kuba2k2/CDCEmu/hardware/v4.0/CDCEmu_v4.0-bottom.png

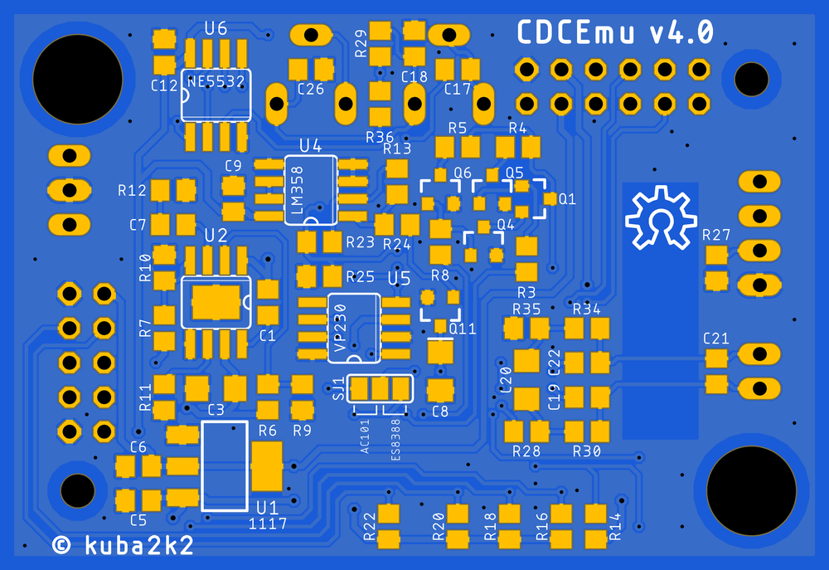
hardware/v4.0/CDCEmu_v4.0-bottom.png
