kuba2k2/CDCEmu/hardware/CDCEmu.brd

## EAGLE design hardware/CDCEmu.brd (2023-04-24)

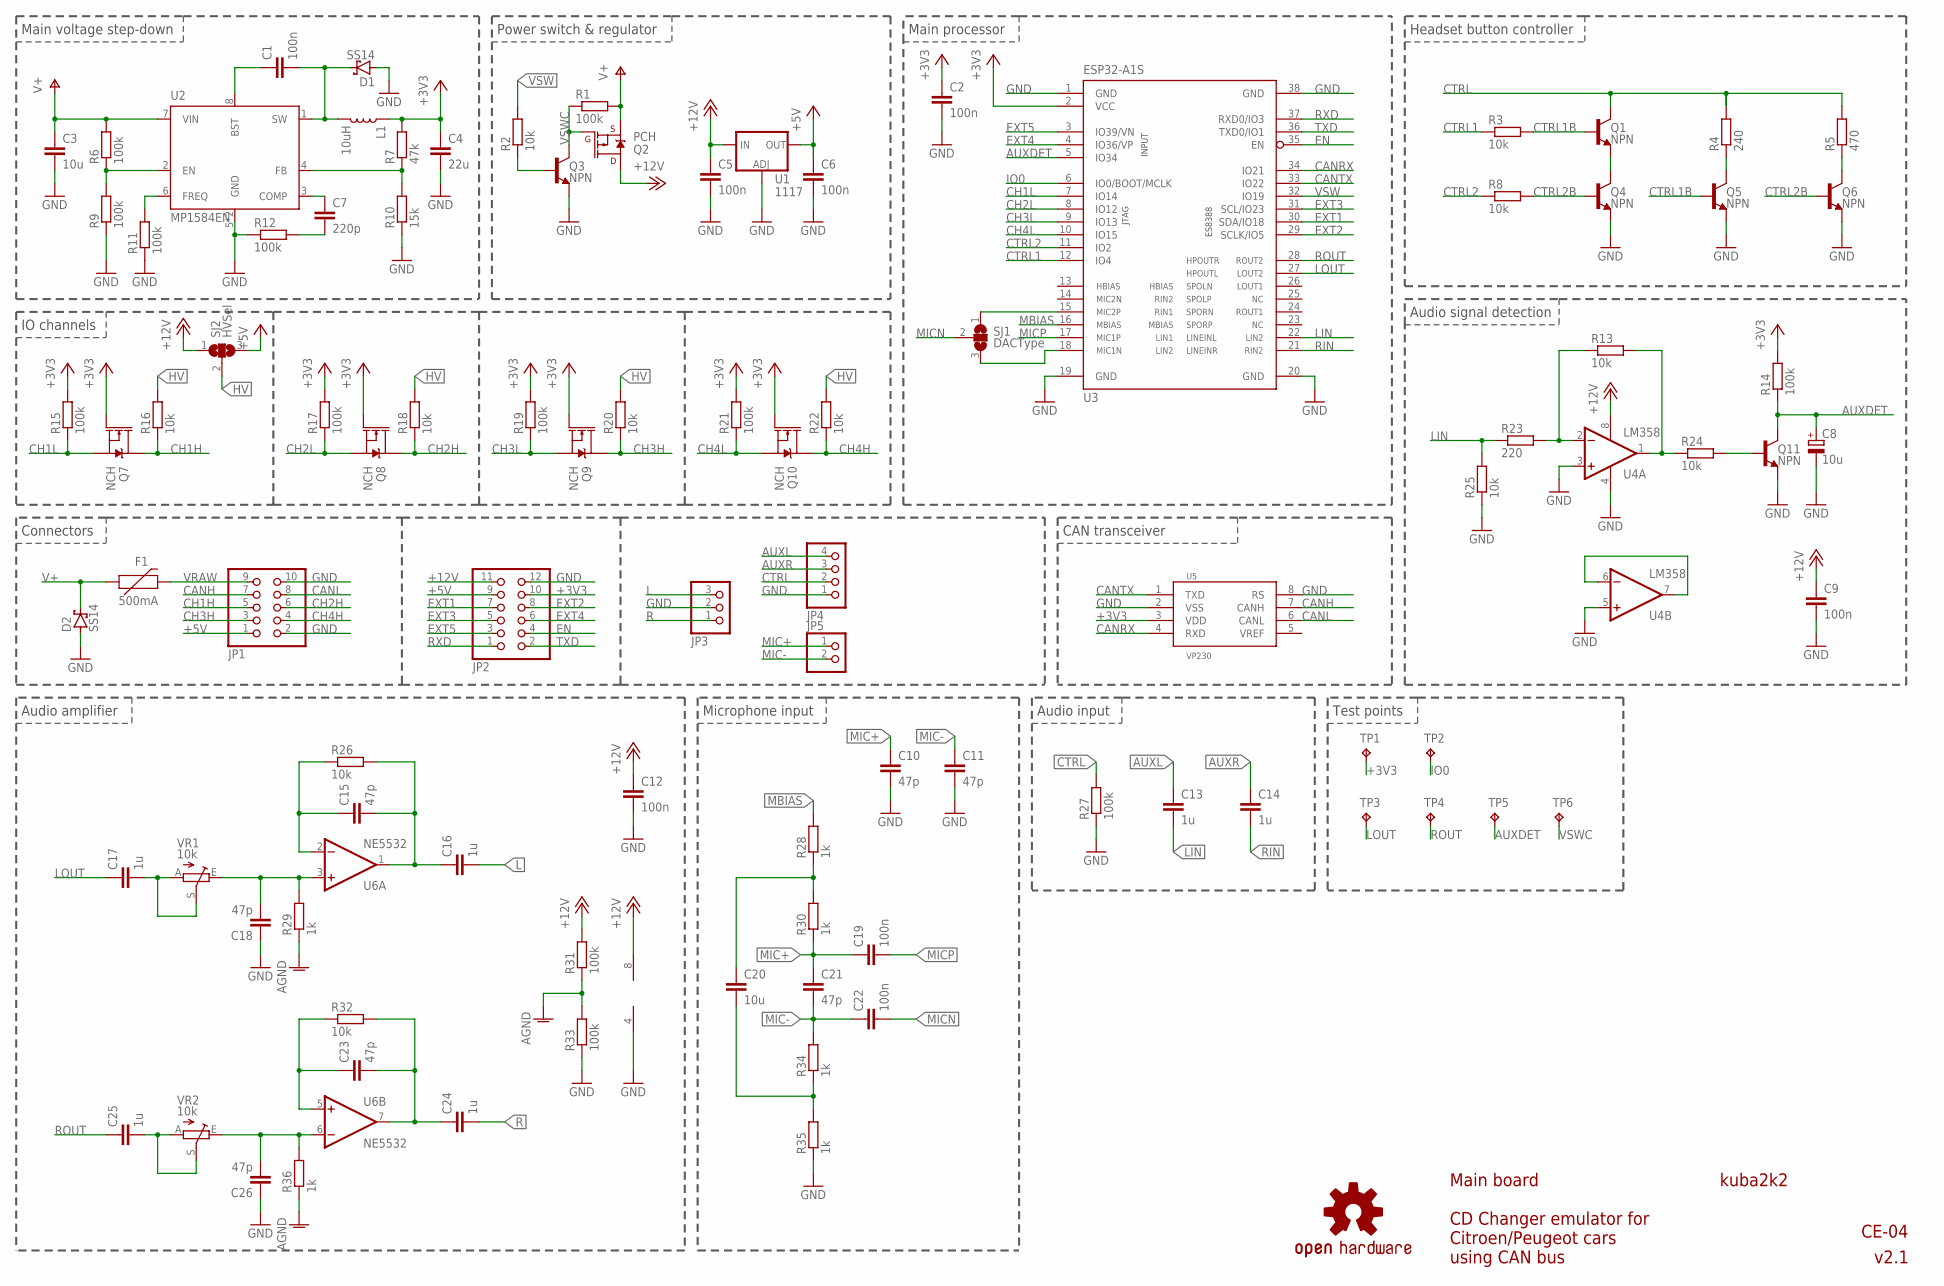
[picture p4: schematic CDCEmu.sch]

Parts:
C1, C2, C5, C6, C9, C12, C19, C22: 100n; C0805
C3, C20: 10u; C1206
C4: 22u; C1206
C7: 220p; C0805
C8: 10u; C1206-POL
C10, C11, C15, C18, C21, C23, C26: 47p; C0805
C13, C14, C16, C17, C24, C25: 1u; C0805
D1, D2: SS14; DO-214AC
F1: 500mA; 0805
JP1: PINHD-2X5/90; 2X05/90
JP2: PINHD-2X6/90; 2X06/90
JP3: PINHD-1X3/90; 1X03/90
JP4: PINHD-1X4/90; 1X04/90
JP5: PINHD-1X2/90; 1X02/90
L1: 10uH; CR75
Q1, Q3, Q4, Q5, Q6, Q11: NPN; SOT23-3
Q2: PCH; SOT23-3
Q7, Q8, Q9, Q10: NCH; SOT23-3
R1, R6, R9, R11, R12, R14, R15, R17, R19, R21, R27, R31, R33: 100k; R0805
R2, R3, R8, R13, R16, R18, R20, R22, R24, R25, R26, R32: 10k; R0805
R4: 240; R0805
R5: 470; R0805
R7: 47k; R0805
R10: 15k; R0805
R23: 220; R0805
R28, R29, R30, R34, R35, R36: 1k; R0805
SJ1: DACType; SJ_2
SJ2: HVSel; SJ_2
TP1, TP2, TP3, TP4, TP5, TP6: TPB1,27; B1,27
U1: 1117; SOT223
U2: MP1584EN; SO08-PAD
U3: ESP32-A1S
U4: LM358; SO08
U5: VP230; SO08
U6: NE5532; SO08
U$1: OSHW-LOGO; OSHWLOGO_TOP_0.2_OUTLINE
VR1, VR2: 10k; CA6V

Connections:
+3V3: C2.1, C4.1, JP2.10, L1.P$1 (1), Q7.1 (G), Q8.1 (G), Q9.1 (G), Q10.1 (G), R7.2, R14.2, R15.2, R17.2, R19.2, R21.2, TP1.TP, U3.2 (VCC), U5.3 (VDD)
+5V: C6.1, JP1.1, JP2.9, SJ2.3, U1.2 (OUT), U1.4 (OUT)
+12V: C5.1, C9.1, C12.1, JP2.11, Q2.3 (D), R31.2, SJ2.1, U1.3 (IN), U4.8 (V+), U6.8 (V+)
AGND: R29.1, R31.1, R33.2, R36.1
AUXDET: C8.1 (+), Q11.3 (C), R14.1, TP5.TP, U3.5 (IO34)
AUXL: C13.1, JP4.4
AUXR: C14.1, JP4.3
BST: C1.1, U2.8 (BST)
CANH: JP1.7, U5.7 (CANH)
CANL: JP1.8, U5.6 (CANL)
CANRX: U3.34 (IO21), U5.4 (RXD)
CANTX: U3.33 (IO22), U5.1 (TXD)
CCE: Q1.2 (E), Q4.3 (C)
CH1H: JP1.5, Q7.3 (D), R16.1
CH1L: Q7.2 (S), R15.1, U3.7 (IO14)
CH2H: JP1.6, Q8.3 (D), R18.1
CH2L: Q8.2 (S), R17.1, U3.8 (IO12)
CH3H: JP1.3, Q9.3 (D), R20.1
CH3L: Q9.2 (S), R19.1, U3.9 (IO13)
CH4H: JP1.4, Q10.3 (D), R22.1
CH4L: Q10.2 (S), R21.1, U3.10 (IO15)
COMP: C7.1, U2.3 (COMP)
COMPD: C7.2, R12.2
CTRL: JP4.2, Q1.3 (C), R4.2, R5.2, R27.2
CTRL1: R3.1, U3.12 (IO4)
CTRL1B: Q1.1 (B), Q5.1 (B), R3.2
CTRL2: R8.1, U3.11 (IO2)
CTRL2B: Q4.1 (B), Q6.1 (B), R8.2
DET-: R13.1, R23.2, U4.2 (-IN)
DETOUT: R13.2, R24.1, U4.1 (OUT)
DET_B: Q11.1 (B), R24.2
EN: JP2.4, U3.35 (EN)
EXT1: JP2.7, U3.30 (SDA/IO18)
EXT2: JP2.8, U3.29 (SCLK/IO5)
EXT3: JP2.5, U3.31 (SCL/IO23)
EXT4: JP2.6, U3.4 (IO36/VP)
EXT5: JP2.3, U3.3 (IO39/VN)
FB: R7.1, R10.2, U2.4 (FB)
FREQ: R11.2, U2.6 (FREQ)
GND: C2.2, C3.2, C4.2, C5.2, C6.2, C8.2 (-), C9.2, C10.2, C11.2, C12.2, C18.1, C26.1, D1.A, D2.A, JP1.2, JP1.10, JP2.12, JP3.2, JP4.1, Q3.2 (E), Q4.2 (E), Q5.2 (E), Q6.2 (E), Q11.2 (E), R9.1, R10.1, R11.1, R12.1, R25.1, R27.1, R33.1, R35.1, U1.1 (ADJ), U2.5 (GND), U2.PAD (GND), U3.1 (GND), U3.19 (GND), U3.20 (GND), U3.38 (GND), U4.3 (+IN), U4.4 (V-), U4.5 (+IN), U5.2 (VSS), U5.8 (RS), U6.4 (V-)
HV: R16.2, R18.2, R20.2, R22.2, SJ2.2
IO0: TP2.TP, U3.6 (IO0/BOOT/MCLK)
L: C16.2, JP3.3
LF: C17.2, VR1.A, VR1.S
LFB: C15.2, C16.1, R26.2, U6.1 (OUT)
LIN: C13.2, R23.1, R25.2, U3.22 (LINEINL/LIN2)
LNEG: C15.1, R26.1, U6.2 (-IN)
LOUT: C17.1, TP3.TP, U3.27 (HPOUTL/LOUT2)
LPOS: C18.2, R29.2, U6.3 (+IN), VR1.E
MBIAS: R28.2, U3.16 (MBIAS)
MG+: C20.1, R28.1, R30.2
MG-: C20.2, R34.1, R35.2
MIC1N: SJ1.3, U3.18 (MIC1N/LIN2)
MIC+: C10.1, C19.1, C21.1, JP5.1, R30.1
MIC-: C11.1, C21.2, C22.1, JP5.2, R34.2
MICN: C22.2, SJ1.2
MICP: C19.2, U3.17 (MIC1P/LIN1)
MPEN: R6.1, R9.2, U2.2 (EN)
Q8C: Q5.3 (C), R4.1
Q9C: Q6.3 (C), R5.1
R: C24.2, JP3.1
RF: C25.2, VR2.A, VR2.S
RFB: C23.2, C24.1, R32.2, U6.7 (OUT)
RIN: C14.2, U3.21 (LINEINR/RIN2)
RIN1: SJ1.1, U3.15 (MIC2P/RIN1)
RNEG: C23.1, R32.1, U6.5 (+IN)
ROUT: C25.1, TP4.TP, U3.28 (HPOUTR/ROUT2)
RPOS: C26.2, R36.2, U6.6 (-IN), VR2.E
RXD: JP2.1, U3.37 (RXD0/IO3)
SW: C1.2, D1.C, L1.P$2 (2), U2.1 (SW)
TXD: JP2.2, U3.36 (TXD0/IO1)
U4FB: U4.6 (-IN), U4.7 (OUT)
V+: C3.1, D2.C, F1.1, Q2.2 (S), R1.2, R6.2, U2.7 (VIN)
VRAW: F1.2, JP1.9
VSW: R2.2, U3.32 (IO19)
VSWB: Q3.1 (B), R2.1
VSWC: Q2.1 (G), Q3.3 (C), R1.1, TP6.TP

Notes on the sheet:
Audio amplifier
Power switch & regulator
Headset button controller
Microphone input
kuba2k2
v2.1
CE-04
CD Changer emulator for Citroen/Peugeot cars using CAN bus
Main board
Audio signal detection
IO channels
Main voltage step-down
Main processor
Connectors
CAN transceiver
Audio input
Test points

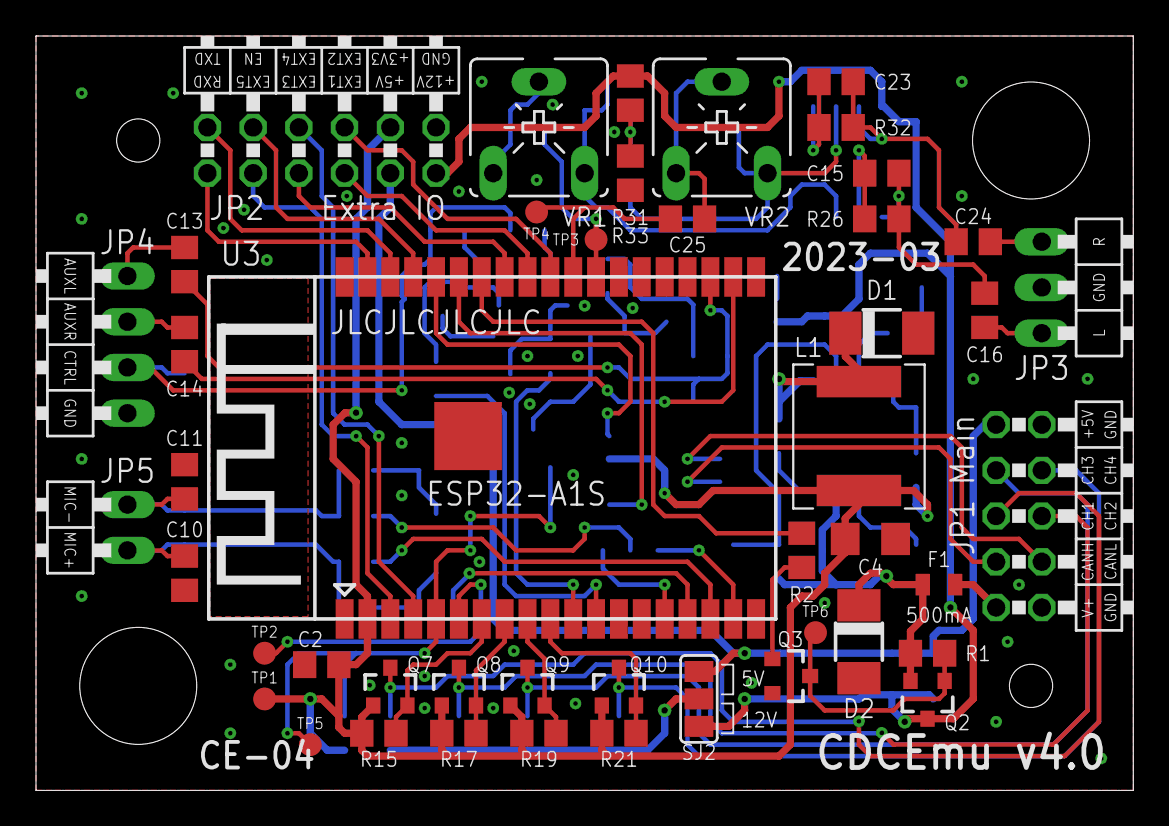
[picture p5: board CDCEmu.brd from above]

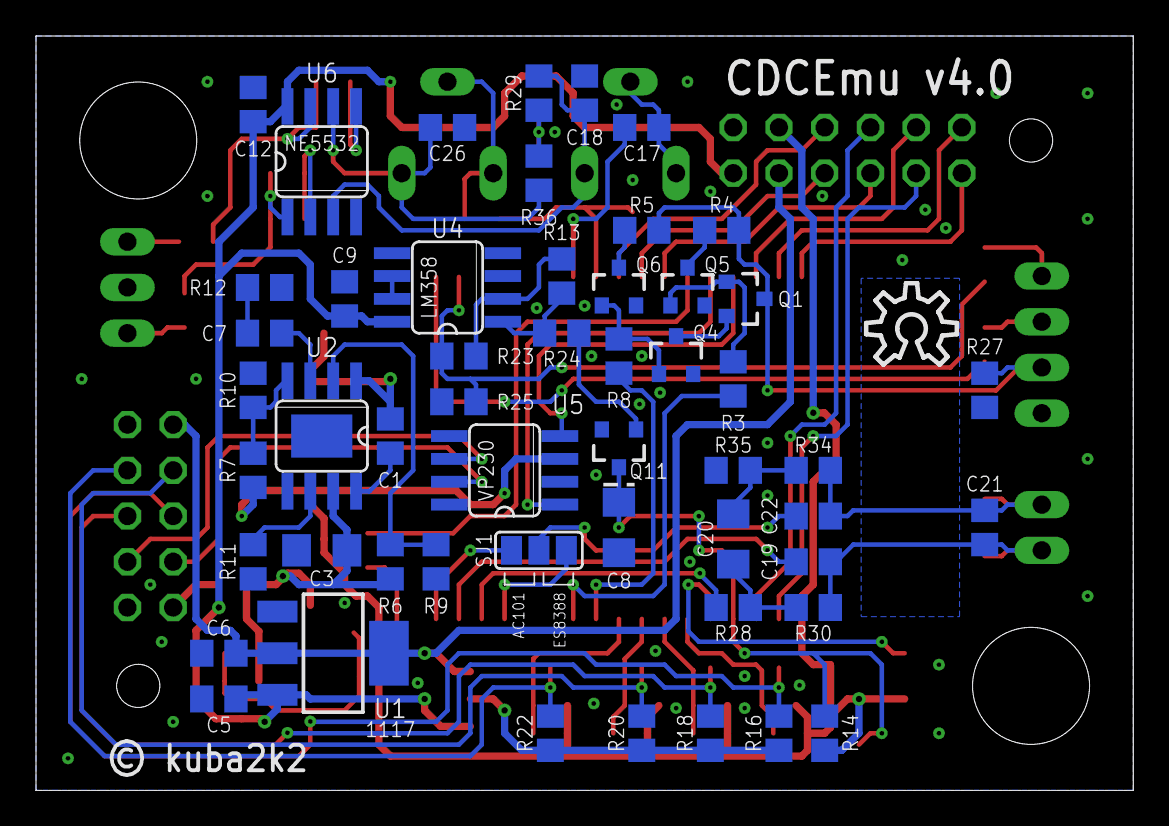
[picture p6: board CDCEmu.brd from below]

Board: 2 copper layers, 61.0 x 41.9 mm, 99 parts (53 on the bottom side), 77 nets.
