kuba2k2/CDCEmu/hardware/v2.1/CDCEmu_Analog_v2.1.brd

## EAGLE design hardware/v2.1/CDCEmu_Analog_v2.1.brd (2022-03-11, an earlier design)

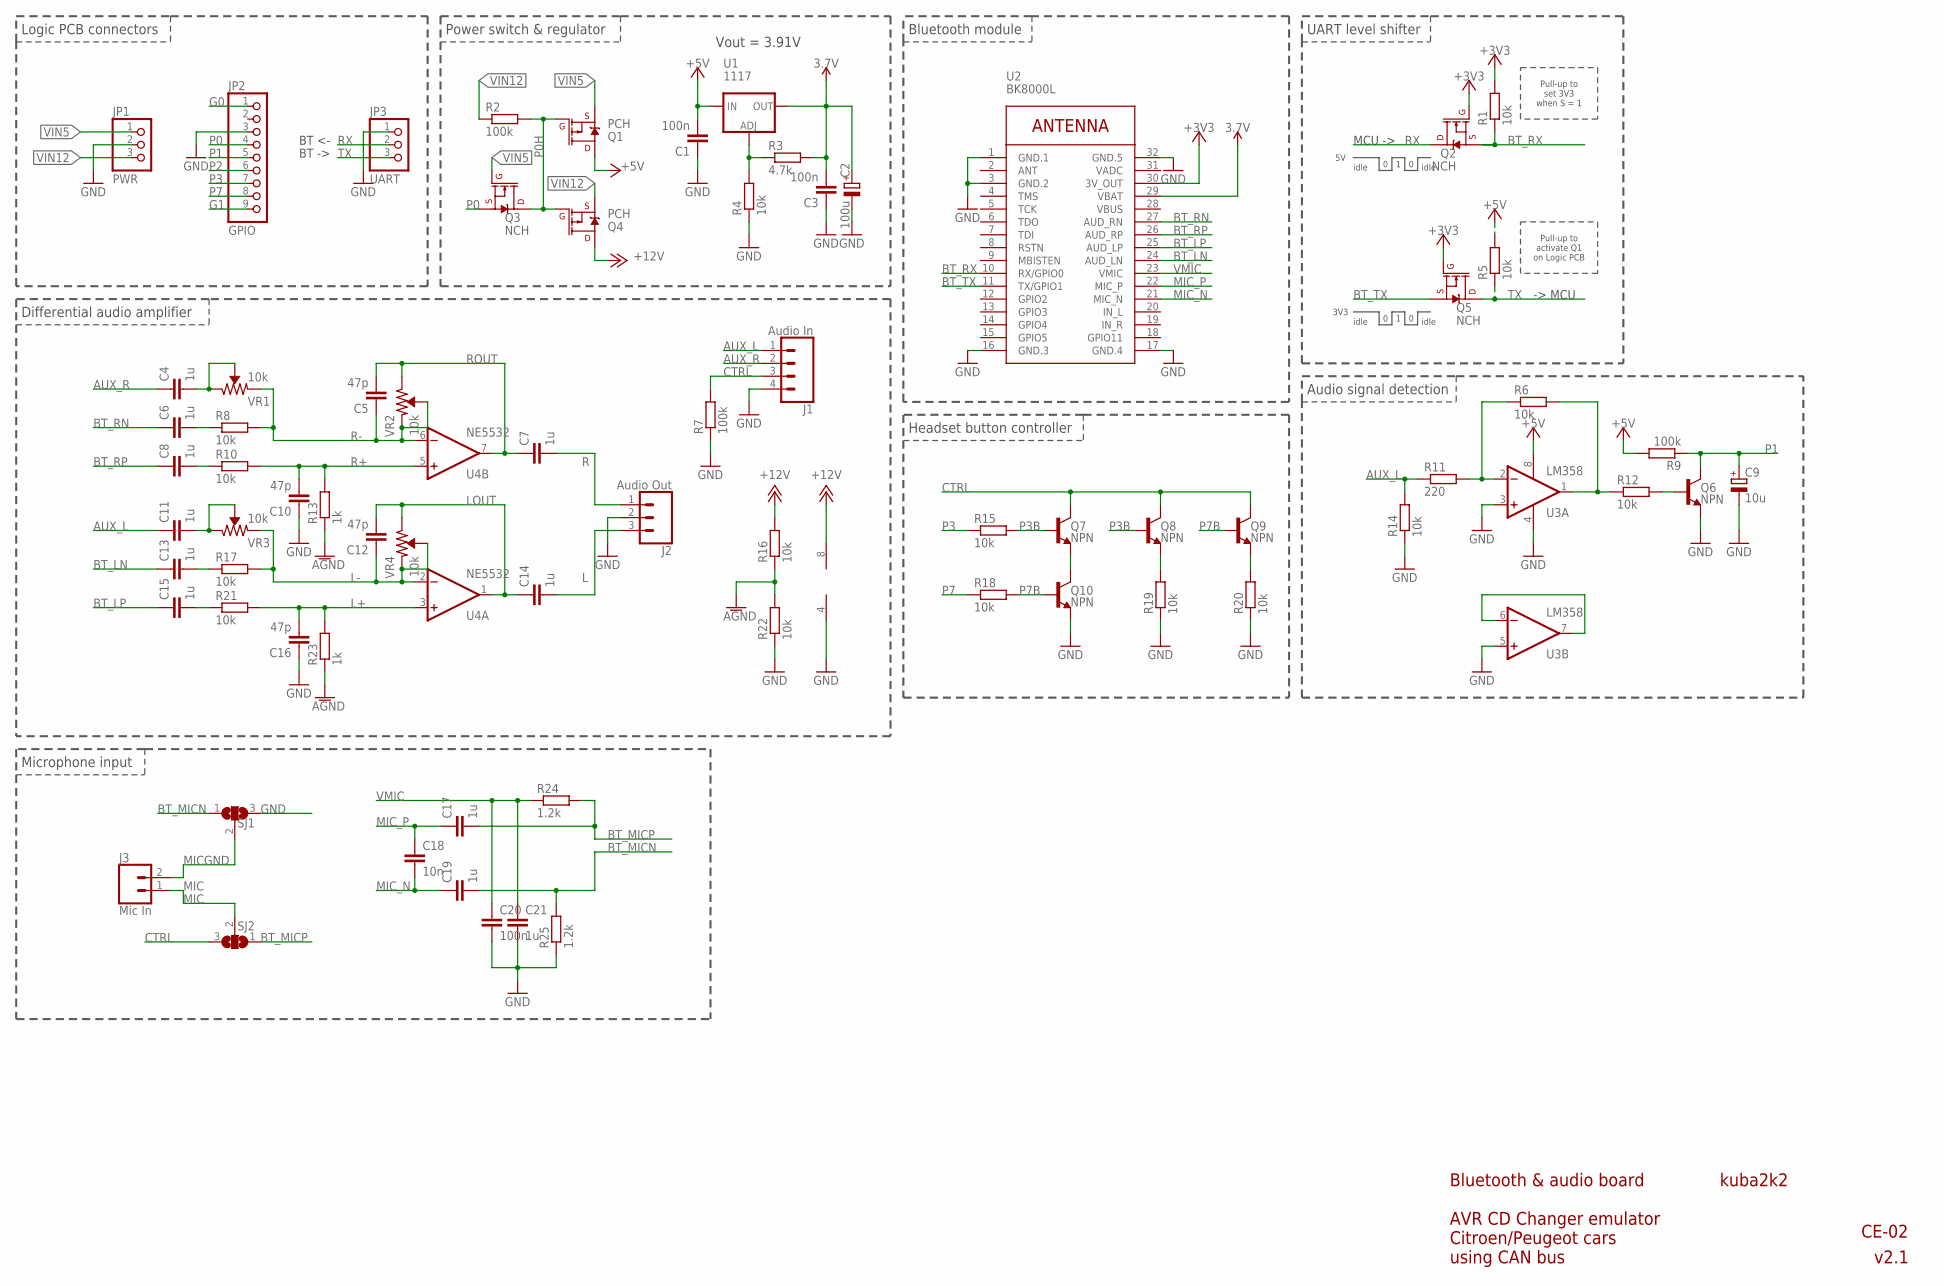
[picture p7: schematic CDCEmu_Analog_v2.1.sch]

Parts:
C1, C3, C20: 100n; C0805
C2: 100u; SMC_B
C4, C6, C7, C8, C11, C13, C14, C15, C17, C19, C21: 1u; C0805
C5, C10, C12, C16: 47p; C0805
C9: 10u; C1206-POL
C18: 10n; C0805
J1: Audio In; JST-4-PTH
J2: Audio Out; JST-3-PTH
J3: Mic In; JST-2-PTH
JP1: PWR; 1X03
JP2: GPIO; 1X09
JP3: UART; 1X03
Q1, Q4: PCH; SOT23-3
Q2, Q3, Q5: NCH; SOT23-3
Q6, Q7, Q8, Q9, Q10: NPN; SOT23-3
R1, R4, R5, R6, R8, R10, R12, R14, R15, R16, R17, R18, R19, R20, R21, R22: 10k; R0805
R2, R7, R9: 100k; R0805
R3: 4.7k; R0805
R11: 220; R0805
R13, R23: 1k; R0805
R24, R25: 1.2k; R0805
SJ1, SJ2: SJ2W; SJ_2
U1: 1117; SOT223
U2: BK8000L; WIRELESS-BLUETOOTH-BK8000
U3: LM358; SO08
U4: NE5532; SO08
VR1, VR2, VR3, VR4: 10k; TRIMPOT-SMD-TC33X

Connections:
3.7V: C2.+, C3.2, R3.2, U1.2 (OUT), U1.4 (OUT), U2.29 (VBAT)
+3V3: Q2.1 (G), Q5.1 (G), R1.2, U2.30 (3V_OUT)
+5V: C1.2, Q1.3 (D), R5.2, R9.2, U1.3 (IN), U3.8 (V+)
+12V: Q4.3 (D), R16.2, U4.8 (V+)
ADJ: R3.1, R4.2, U1.1 (ADJ)
AGND: R13.1, R16.1, R22.2, R23.1
AUX_L: C11.1, J1.1, R11.1, R14.2
AUX_R: C4.1, J1.2
BT_LN: C13.1, U2.24 (AUD_LN)
BT_LP: C15.1, U2.25 (AUD_LP)
BT_MICN: C19.2, R25.2, SJ1.1
BT_MICP: C17.2, R24.2, SJ2.1
BT_RN: C6.1, U2.27 (AUD_RN)
BT_RP: C8.1, U2.26 (AUD_RP)
BT_RX: Q2.2 (S), R1.1, U2.10 (RX/GPIO0)
BT_TX: Q5.2 (S), U2.11 (TX/GPIO1)
CCE: Q7.2 (E), Q10.3 (C)
CTRL: J1.3, Q7.3 (C), Q8.3 (C), Q9.3 (C), R7.2, SJ2.3
DET-: R6.1, R11.2, U3.2 (-IN)
DETOUT: R6.2, R12.1, U3.1 (OUT)
DET_B: Q6.1 (B), R12.2
G0: JP2.1
G1: JP2.9
GND: C1.1, C2.-, C3.1, C9.2 (-), C10.1, C16.1, C20.2, C21.2, J1.4, J2.2, JP1.2, JP2.3, JP3.1, Q6.2 (E), Q10.2 (E), R4.1, R7.1, R14.1, R19.1, R20.1, R22.1, R25.1, SJ1.3, U2.1 (GND.1), U2.3 (GND.2), U2.16 (GND.3), U2.17 (GND.4), U2.32 (GND.5), U3.3 (+IN), U3.4 (V-), U3.5 (+IN), U4.4 (V-)
L: C14.2, J2.3
L1: C11.2, VR3.1 (CW), VR3.2 (WIPER)
L2: C13.2, R17.1
L3: C15.2, R21.1
L+: C16.2, R21.2, R23.2, U4.3 (+IN)
L-: C12.1, R17.2, U4.2 (-IN), VR3.3 (CCW), VR4.2 (WIPER), VR4.3 (CCW)
LOUT: C12.2, C14.1, U4.1 (OUT), VR4.1 (CW)
MIC: J3.1, SJ2.2
MICGND: J3.2, SJ1.2
MIC_N: C18.2, C19.1, U2.21 (MIC_N)
MIC_P: C17.1, C18.1, U2.22 (MIC_P)
P0: JP2.4, Q3.2 (S)
P0H: Q1.1 (G), Q3.3 (D), Q4.1 (G), R2.2
P1: C9.1 (+), JP2.5, Q6.3 (C), R9.1
P2: JP2.6
P3: JP2.7, R15.1
P3B: Q7.1 (B), Q8.1 (B), R15.2
P7: JP2.8, R18.1
P7B: Q9.1 (B), Q10.1 (B), R18.2
Q7E: Q8.2 (E), R19.2
Q8E: Q9.2 (E), R20.2
R: C7.2, J2.1
R1: C4.2, VR1.1 (CW), VR1.2 (WIPER)
R2: C6.2, R8.1
R3: C8.2, R10.1
R+: C10.2, R10.2, R13.2, U4.5 (+IN)
R-: C5.1, R8.2, U4.6 (-IN), VR1.3 (CCW), VR2.2 (WIPER), VR2.3 (CCW)
ROUT: C5.2, C7.1, U4.7 (OUT), VR2.1 (CW)
RX: JP3.2, Q2.3 (D)
TX: JP3.3, Q5.3 (D), R5.1
U4FB: U3.6 (-IN), U3.7 (OUT)
VADC: U2.31 (VADC)
VIN5: JP1.1, Q1.2 (S), Q3.1 (G)
VIN12: JP1.3, Q4.2 (S), R2.1
VMIC: C20.1, C21.1, R24.1, U2.23 (VMIC)

Notes on the sheet:
Differential audio amplifier
Logic PCB connectors
Power switch & regulator
BT <-
BT ->
MCU ->
-> MCU
UART level shifter
Pull-up to activate Q1 on Logic PCB
idle
Pull-up to set 3V3 when S = 1
Bluetooth module
Headset button controller
Microphone input
3V3
kuba2k2
v2.1
CE-02
Vout = 3.91V
AVR CD Changer emulator Citroen/Peugeot cars using CAN bus
Bluetooth & audio board
Audio signal detection

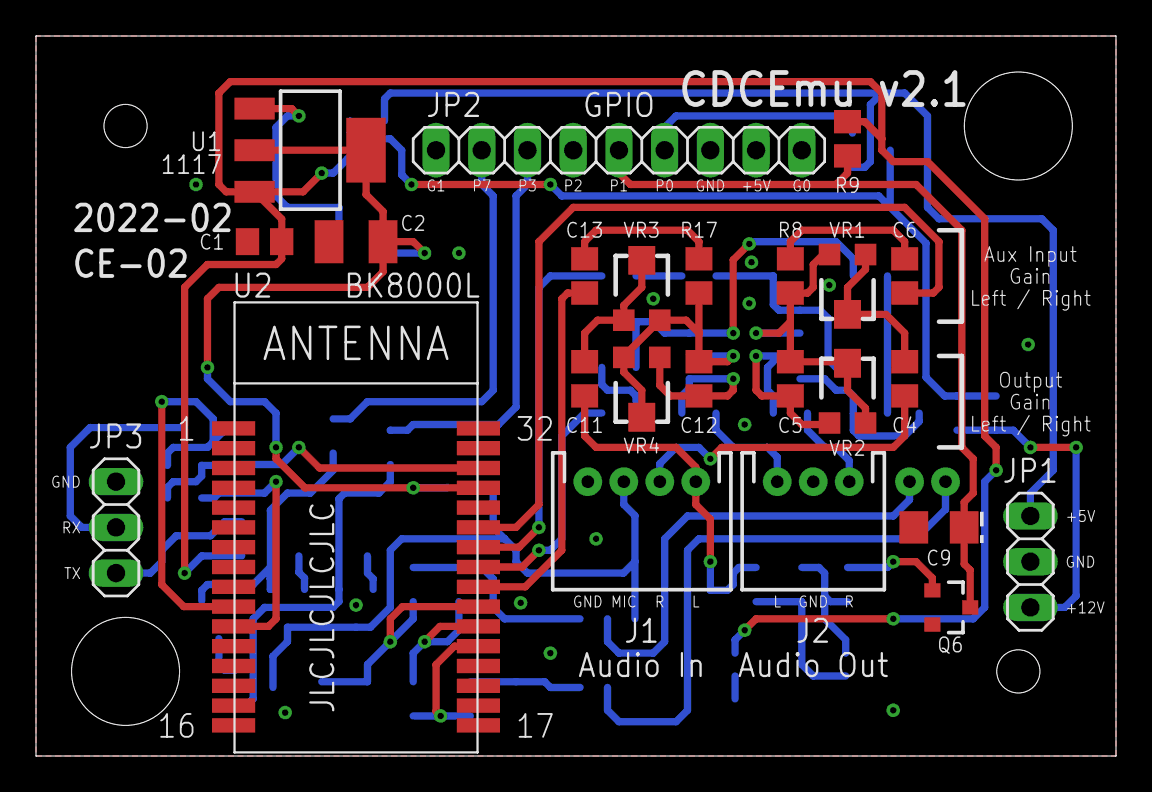
[picture p8: board CDCEmu_Analog_v2.1.brd from above]

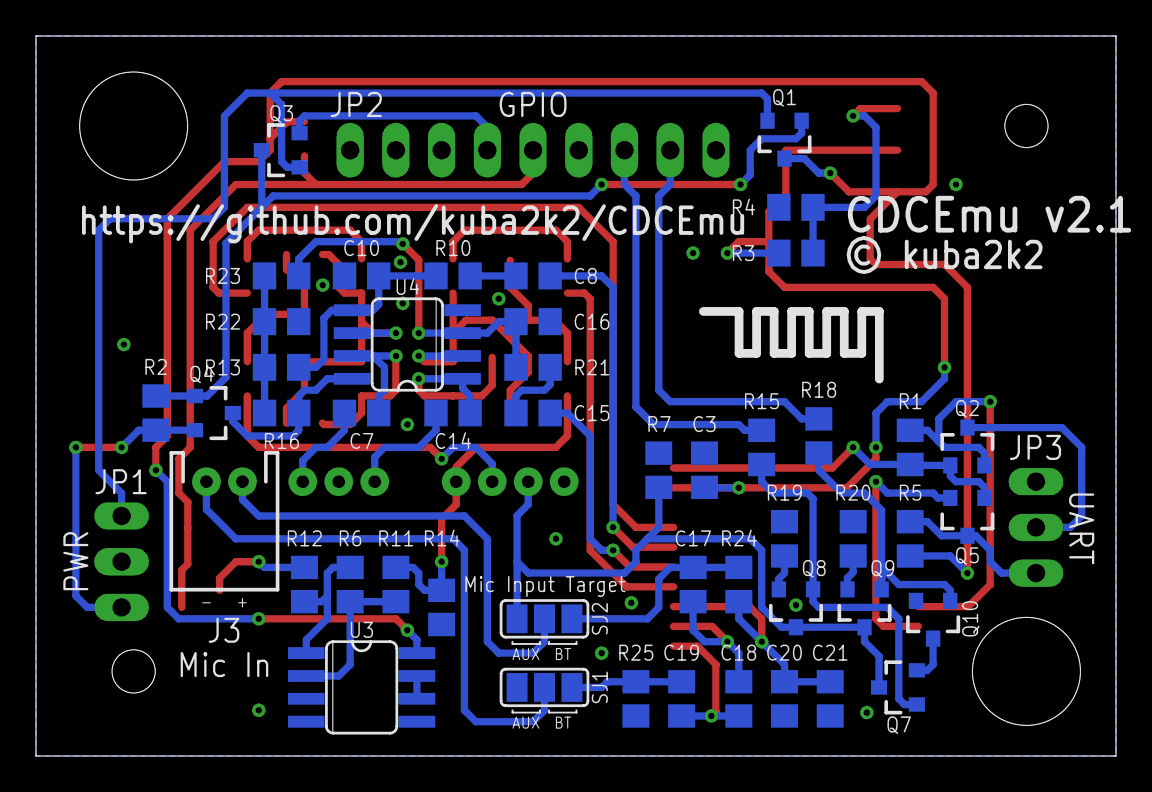
[picture p9: board CDCEmu_Analog_v2.1.brd from below]

Board: 2 copper layers, 60.0 x 40.0 mm, 72 parts (48 on the bottom side), 55 nets.
