kuba2k2/CDCEmu/hardware/v2.1/CDCEmu_Logic_v2.1.brd

## EAGLE design hardware/v2.1/CDCEmu_Logic_v2.1.brd (2022-03-11, an earlier design)

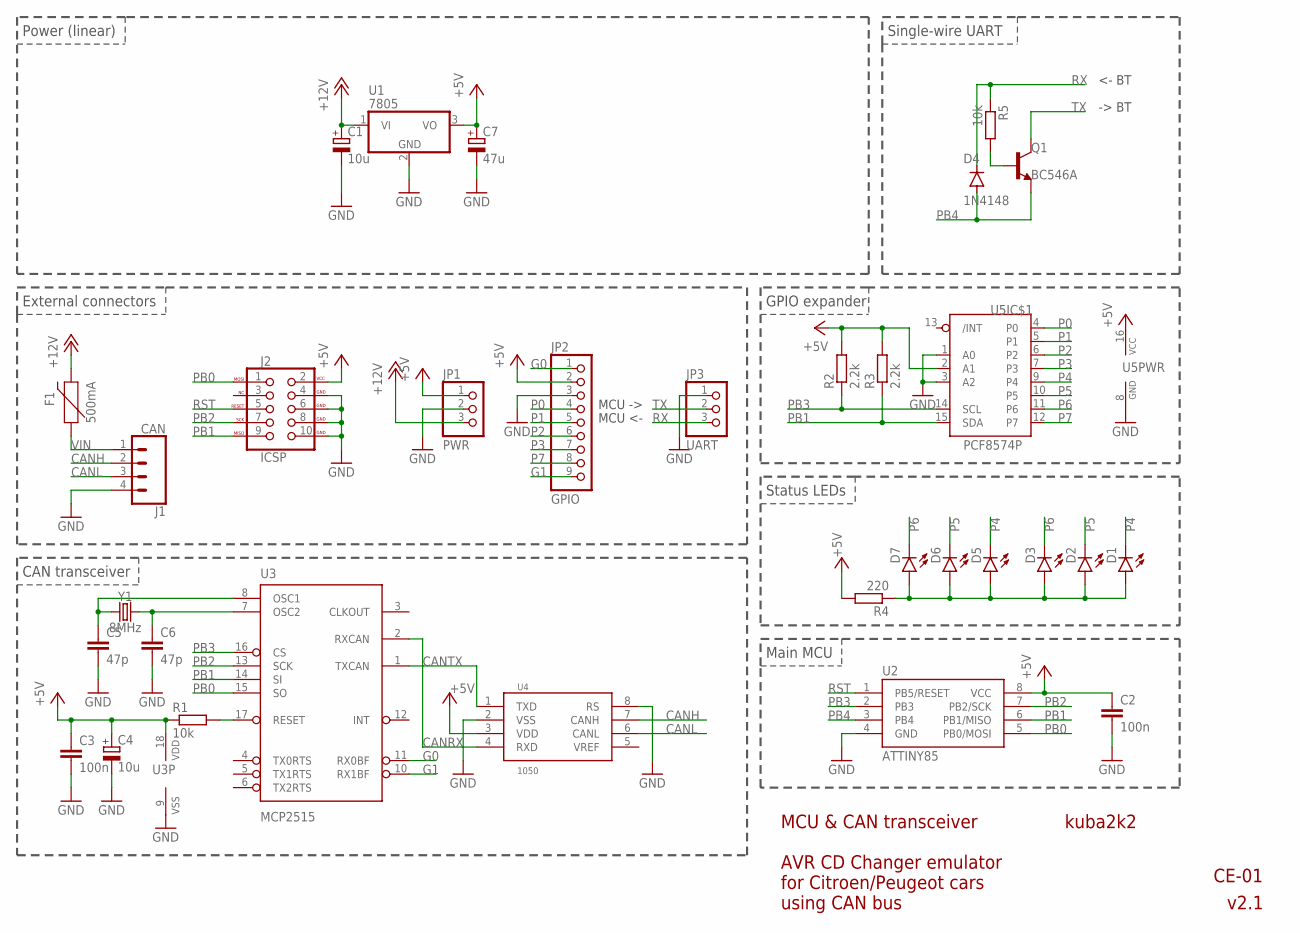
[picture p10: schematic CDCEmu_Logic_v2.1.sch]

Parts:
C1: 10u; C2512-POL
C2, C3: 100n; C050-024X044
C4: 10u; E2,5-6
C5, C6: 47p; C0805
C7: 47u; C2512-POL
D1, D2, D3: LED3MM
D4: 1N4148; DO35-7
D5, D6, D7: LEDCHIP-LED0805; CHIP-LED0805
F1: 500mA; 1812
J1: CAN; JST-4-PTH
J2: ICSP; 2X5-SHROUDED_LOCK
JP1: PWR; 1X03
JP2: GPIO; 1X09
JP3: UART; 1X03
Q1: BC546A; TO92-EBC
R1: 10k; R0805
R2, R3: 2.2k; R0805
R4: 220; 0204/7
R5: 10k; 0204/7
U1: 7805; TO220H-NOHOLE
U2: ATTINY85; PDIP08_300MIL
U3: MCP2515; SO18W
U4: 1050; SO08
U5: PCF8574P; DIL16
Y1: 8MHz; HC49U

Connections:
+5V: C2.1, C3.1, C4.+, C7.+, J2.2 (VCC), JP1.1, JP2.2, R1.1, R2.2, R3.2, R4.2, U1.3 (VO), U2.8 (VCC), U3.18 (VDD), U4.3 (VDD), U5.2 (A1), U5.16 (VCC)
+12V: C1.+, F1.2, JP1.3, U1.1 (VI)
CANH: J1.2, U4.7 (CANH)
CANL: J1.3, U4.6 (CANL)
CANOSC1: C5.1, U3.8 (OSC1), Y1.1
CANOSC2: C6.1, U3.7 (OSC2), Y1.2
CANRST: R1.2, U3.17 (RESET)
CANRX: U3.2 (RXCAN), U4.4 (RXD)
CANTX: U3.1 (TXCAN), U4.1 (TXD)
G0: JP2.1, U3.11 (RX0BF)
G1: JP2.9, U3.10 (RX1BF)
GND: C1.-, C2.2, C3.2, C4.-, C5.2, C6.2, C7.-, J1.4, J2.4 (GND), J2.6 (GND), J2.8 (GND), J2.10 (GND), JP1.2, JP2.3, JP3.1, U1.2 (GND), U2.4 (GND), U3.9 (VSS), U4.2 (VSS), U4.8 (RS), U5.1 (A0), U5.3 (A2), U5.8 (GND)
LED_A: D1.A, D2.A, D3.A, D5.A, D6.A, D7.A, R4.1
P0: JP2.4, U5.4 (P0)
P1: JP2.5, U5.5 (P1)
P2: JP2.6, U5.6 (P2)
P3: JP2.7, U5.7 (P3)
P4: D1.K (C), D5.C, U5.9 (P4)
P5: D2.K (C), D6.C, U5.10 (P5)
P6: D3.K (C), D7.C, U5.11 (P6)
P7: JP2.8, U5.12 (P7)
PB0: J2.1 (MOSI), U2.5 (PB0/MOSI), U3.15 (SO)
PB1: J2.9 (MISO), R3.1, U2.6 (PB1/MISO), U3.14 (SI), U5.15 (SDA)
PB2: J2.7 (SCK), U2.7 (PB2/SCK), U3.13 (SCK)
PB3: R2.1, U2.2 (PB3), U3.16 (CS), U5.14 (SCL)
PB4: D4.A, Q1.E, U2.3 (PB4)
RST: J2.5 (RESET), U2.1 (PB5/RESET)
RX: D4.C, JP3.3, R5.1
TX: JP3.2, Q1.C
TXB: Q1.B, R5.2
VIN: F1.1, J1.1

Notes on the sheet:
Power (linear)
Single-wire UART
External connectors
CAN transceiver
Main MCU
Status LEDs
GPIO expander
-> BT
<- BT
MCU ->
MCU <-
kuba2k2
v2.1
CE-01
AVR CD Changer emulator for Citroen/Peugeot cars using CAN bus
MCU & CAN transceiver

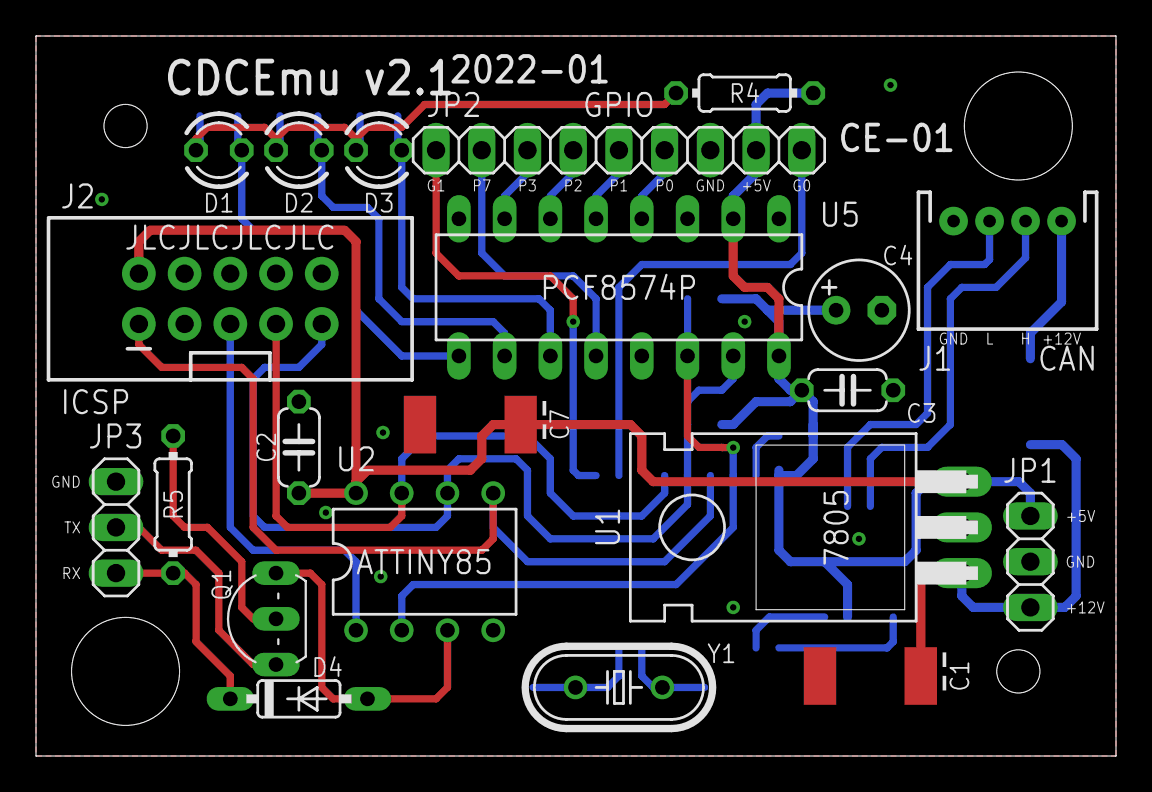
[picture p11: board CDCEmu_Logic_v2.1.brd from above]

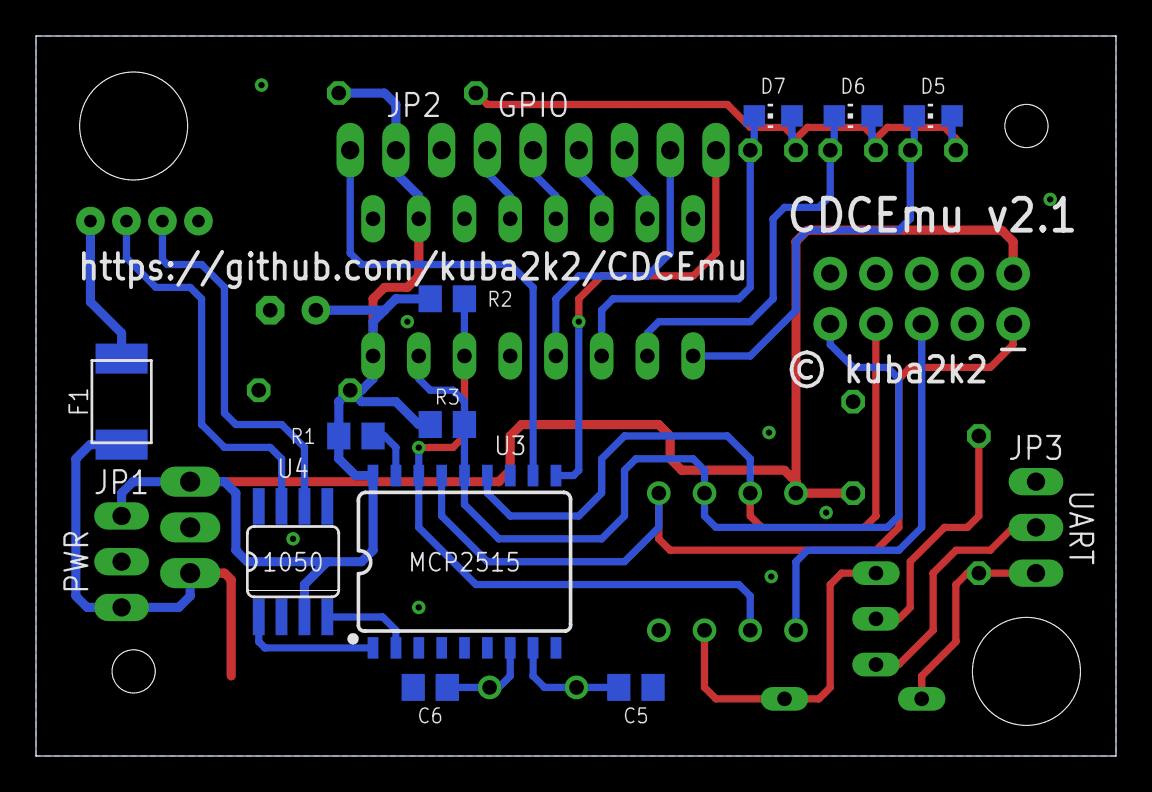
[picture p12: board CDCEmu_Logic_v2.1.brd from below]

Board: 2 copper layers, 60.0 x 40.0 mm, 32 parts (11 on the bottom side), 31 nets.
