kuba2k2/CDCEmu/src/can.h

#pragma once

#include <stdint.h>

#define IGNITION_OFF	   0
#define IGNITION_ON		   1
#define IGNITION_POWERSAVE 2
#define IGNITION_ON_FIRST  3

#define PACKET_DEF(id, dlc, data_bytes, ...)			   (dlc << 4) | (id >> 8), (id & 0xff), ##__VA_ARGS__, (data_bytes)
#define PACKET_DATA(src_byte, src_mask, dst_byte, dst_rsh) (src_mask << 3) | (dst_rsh), (src_byte << 4) | (dst_byte)
#define PACKET_META(address, timer, delay, flag)		   (address), T_MS(delay), (timer << 4) | (flag)

extern struct can_message msg;

bool can_init();
void can_receive_all();
void can_send_all();
