kuba2k2/CDCEmu/(commit log)

2021-05-15 Fix compatibility with Arduino IDE
2021-05-15 Add local MCP2515 library to support ATtiny SPI.
2021-05-15 Support Arduino and ATtiny debug logging
2021-05-20 Add i2c library
2021-05-20 Add uart library
2021-05-23 Add spi library
2021-05-24 Implement delay timers
2021-05-28 Move global timers to Timer1
2021-05-28 Replace picoUART with the AVR274 Single-wire Software UART
    [config.h, main.cpp, single_wire_UART.c, single_wire_UART.h, uart.h]
2021-05-30 Rename UART-related methods
2021-05-30 Remove stdio UART debug methods
2021-05-30 Implement UART RX buffer
2021-05-31 Implement UART TX buffer
2021-05-31 Remove unused UART flag defines
2021-05-31 Implement UART string receiving and pgmspace transmitting
2021-05-31 Add UART RX buffer flushing
2021-05-31 Add sample AT command support
2021-06-24 Fix packet timers skipping issue
    [can.cpp, timers.cpp, timers.h]
2021-06-24 Allow using up to 16 timers and data bytes
2021-06-24 Add status LEDs
2021-06-25 Fix sleep mode, again
    [main.cpp]
2022-03-07 Add hardware design files
    [CDCEmu_Logic.brd, CDCEmu_Logic.sch]
2022-03-07 Release hardware v2.0
    [CDCEmu_Logic_v2.0.brd, CDCEmu_Logic_v2.0.sch]
2022-03-07 [HW] Refactor logic PCB
    [CDCEmu_Logic.brd, CDCEmu_Logic.sch]
2022-03-07 [HW] Add audio PCB design files
    [CDCEmu_Analog.brd, CDCEmu_Analog.sch]
2022-03-07 [HW] Add Logic PCB AP5100 step-down variant (unfinished, deprecated)
    [CDCEmu_Logic_stepdown.brd, CDCEmu_Logic_stepdown.sch]
2022-03-08 [HW] Add audio gain control trimpots
    [CDCEmu_Analog.brd, CDCEmu_Analog.sch]
2022-03-10 [HW/Logic] Add pinout labels to connectors
    [CDCEmu_Logic.brd]
2022-03-10 [HW/Analog] Add audio signal detection
    [CDCEmu_Analog.brd, CDCEmu_Analog.sch]
2022-03-10 [HW/Analog] Separate Q8 and Q9
    [CDCEmu_Analog.brd]
2022-03-10 [HW/Logic] Change preview soldermask color, move texts
    [CDCEmu_Logic.brd]
2022-03-11 [HW] Release v2.1
    [CDCEmu_Analog_v2.1.brd, CDCEmu_Analog_v2.1.sch, CDCEmu_Logic_v2.1.brd, CDCEmu_Logic_v2.1.sch]
2022-04-13 [FW] Add UART debug macros
2022-04-15 [FW] Add initial support for Analog PCB
2022-07-08 [HW/Analog] Fix swapped Bluetooth RX and TX
    [CDCEmu_Analog.brd, CDCEmu_Analog.sch]
2022-07-08 [HW/Analog] Correct Vol+/- control transistors
    [CDCEmu_Analog.brd, CDCEmu_Analog.sch]
2023-04-02 [HW] Release v4.0
    [CDCEmu.brd, CDCEmu.sch, CDCEmu_Analog.brd, CDCEmu_Analog.sch, CDCEmu_Logic.brd, CDCEmu_Logic.sch, CDCEmu_Logic_stepdown.brd, CDCEmu_Logic_stepdown.sch]
2023-04-24 [HW] Correct resistor values
    [CDCEmu.brd, CDCEmu.sch, CDCEmu_v4.0.brd, CDCEmu_v4.0.sch]
