kuba2k2/CDCEmu/(notices)

Notices in the files:
hardware/v2.1/CDCEmu_Logic_v2.1.brd:
© kuba2k2
parts and their libraries:
SparkFun-IC-Comms: Licensing: Creative Commons ShareAlike 4.0 International - https://creativecommons.org/licenses/by-sa/4.0
diy-modules: Released under the Creative Commons Attribution 4.0 International License: http://creativecommons.org/licenses/by/4.0
